JeffLupia/The-Fetal-Pig-Study-Buddy/vein_diagram_du.jpg

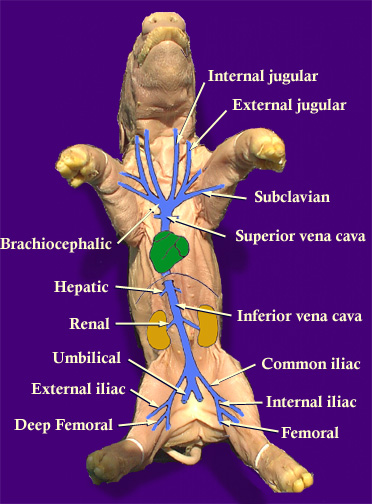
vein_diagram_du.jpg
