JeffLupia/The-Fetal-Pig-Study-Buddy/IMG_1502.JPG

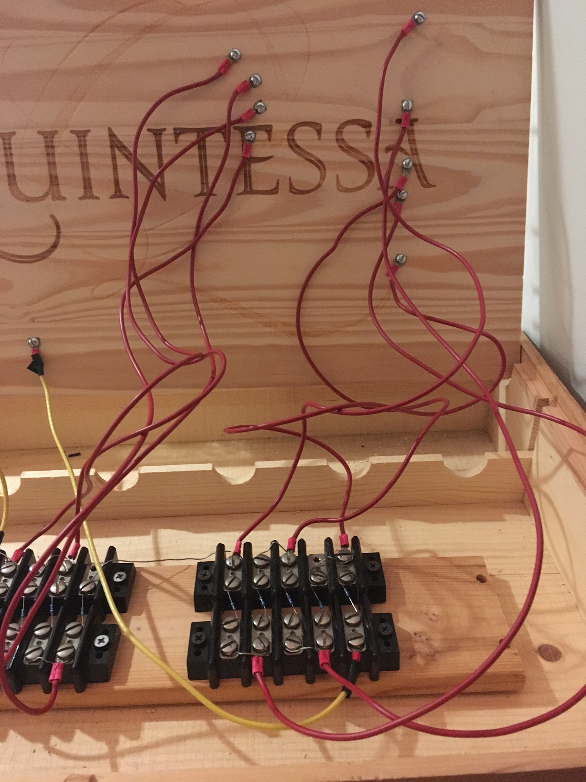
IMG_1502.JPG
